jbeuckm/thrust_bucket/eagle/thrust_stand.brd

## EAGLE design eagle/thrust_stand.brd (2017-02-22)

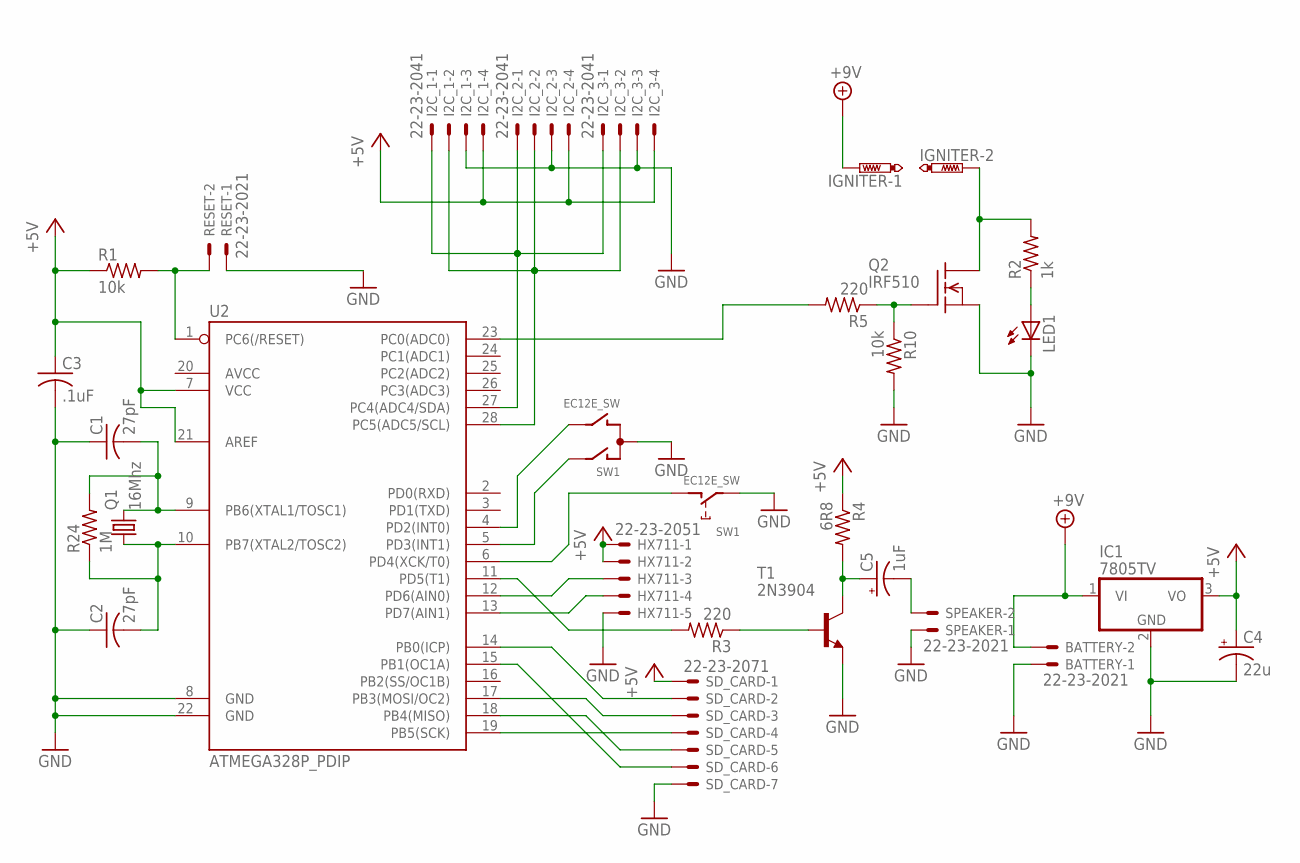
[picture p3: schematic thrust_stand.sch]

Parts:
BATTERY: 22-23-2021
C1, C2: 27pF; C025-040X050
C3: .1uF; C025-030X050
C4: 22u; B45181A
C5: 1uF; B45181A
HX711: 22-23-2051
I2C_1, I2C_2, I2C_3: 22-23-2041
IC1: 7805TV; TO220V
IGNITER: PTR2; P2-38-17
LED1: LED5MM
Q1: 16Mhz; HC49/S
Q2: IRF510; TO220
R1, R10: 10k; 0207/7
R2: 1k; 0207/7
R3: 220; 0207/7
R4: 6R8; 0207/7
R5: 220; 0309/10
R24: 1M; 0207/7
RESET: 22-23-2021
SD_CARD: 22-23-2071
SPEAKER: 22-23-2021
SW1: EC12E_SW; ALPS_EC12E_SW
T1: 2N3904; TO92
U2: ATMEGA328P_PDIP; DIL28-3

Connections:
+5V: C3.1, C4.+, HX711.1, HX711.2, I2C_1.4, I2C_2.4, I2C_3.4, IC1.3 (VO), R1.1, R4.1, SD_CARD.1, U2.7 (VCC), U2.21 (AREF)
+9V: BATTERY.2, IC1.1 (VI), IGNITER.TP-1
GND: BATTERY.1, C1.1, C2.1, C3.2, C4.-, HX711.5, I2C_1.3, I2C_2.3, I2C_3.3, IC1.2 (GND), LED1.K (C), Q2.3 (S), R10.2, RESET.1, SD_CARD.7, SPEAKER.1, SW1.C, SW1.E (2), T1.3 (E), U2.8 (GND), U2.22 (GND)
unnamed: I2C_1.2, I2C_2.2, I2C_3.2, U2.28 (PC5(ADC5/SCL))
unnamed: I2C_1.1, I2C_2.1, I2C_3.1, U2.27 (PC4(ADC4/SDA))
unnamed: HX711.3, U2.12 (PD6(AIN0))
unnamed: C1.2, Q1.2, R24.2, U2.9 (PB6(XTAL1/TOSC1))
unnamed: C2.2, Q1.1, R24.1, U2.10 (PB7(XTAL2/TOSC2))
unnamed: HX711.4, U2.13 (PD7(AIN1))
unnamed: SD_CARD.2, U2.14 (PB0(ICP))
unnamed: SD_CARD.3, U2.17 (PB3(MOSI/OC2))
unnamed: SD_CARD.4, U2.19 (PB5(SCK))
unnamed: SD_CARD.5, U2.18 (PB4(MISO))
unnamed: SD_CARD.6, U2.15 (PB1(OC1A))
unnamed: Q2.1 (G), R5.1, R10.1
unnamed: R3.2, U2.11 (PD5(T1))
unnamed: R3.1, T1.2 (B)
unnamed: C5.+, R4.2, T1.1 (C)
unnamed: C5.-, SPEAKER.2
unnamed: IGNITER.TP-2, Q2.2 (D), R2.2
unnamed: R5.2, U2.23 (PC0(ADC0))
unnamed: SW1.B, U2.4 (PD2(INT0))
unnamed: SW1.A, U2.5 (PD3(INT1))
unnamed: LED1.A, R2.1
unnamed: SW1.D (1), U2.6 (PD4(XCK/T0))
unnamed: R1.2, RESET.2, U2.1 (PC6(/RESET))

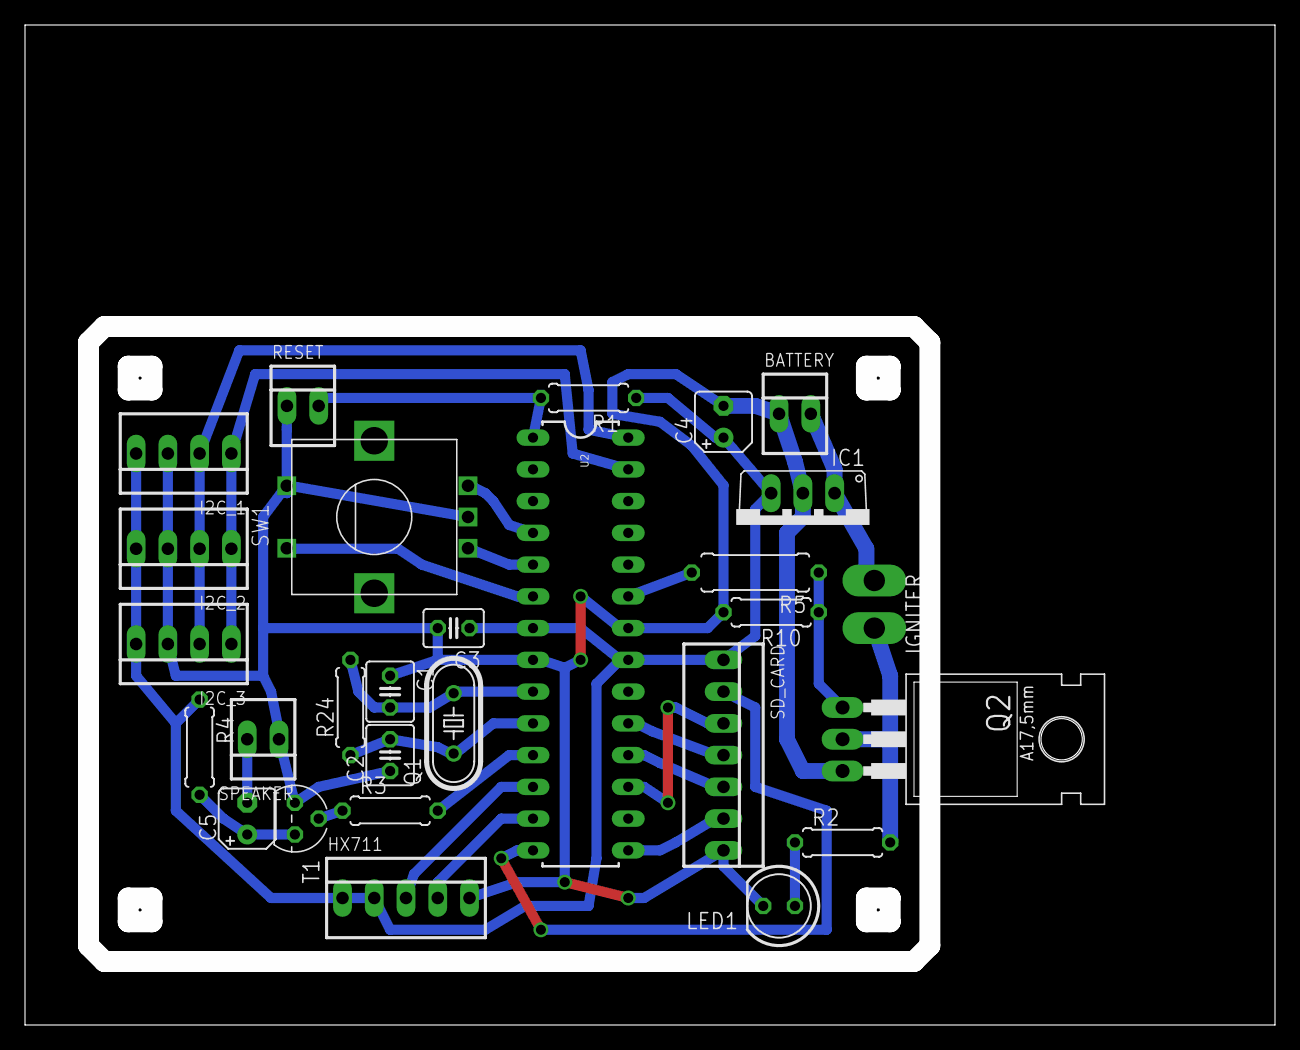
[picture p4: board thrust_stand.brd from above]

Board: 2 copper layers, 100.0 x 80.0 mm, 28 parts (0 on the bottom side), 26 nets.
