jbeuckm/thrust_bucket/sd_card/TESTS.CSV

THRUST0.TSV
THRUST23.TSV
