jbeuckm/thrust_bucket/(threads)

Thread 1 (2017-02-18):

Improve Calibration Process

jbeuckm, 2017-02-18:
When in calibration mode with Calibration function selected...

Button down: Turn knob to make ballpark changes to scale value
Button up: Turn knob to make fine adjustment
Button down/up again: release the knob for function select/mode change

jbeuckm, 2017-02-21:
handled in 4064e74a9a2209aa1cbc943495d86aceadedaa5f

Closed 2017-02-21.
