jbeuckm/thrust_bucket/thrust_bucket_atmega/IgniteMode.cpp

/*
 * IgniteMode.cpp
 *
 *  Created on: Feb 11, 2017
 *      Author: joebeuckman
 */

#include "IgniteMode.h"
#include "ChangeModeFunction.h"


IgniteMode::IgniteMode(HX711 *_scale, rgb_lcd *_lcd): BaseMode(_scale, _lcd) {
	scale = _scale;
	lcd = _lcd;
	functionIndex = 0;

	FUNCTION_COUNT = 1;

	modeFunctions = (BaseModeFunction **) malloc(FUNCTION_COUNT * sizeof(BaseModeFunction*));

	modeFunctions[0] = new ChangeModeFunction(F("[Cancel]"), -2);

	setupSDcard();

	Serial.println(F("IgniteMode() complete"));
}


void IgniteMode::setupSDcard() {
	pinMode(IGNITER_PIN, OUTPUT);

	pinMode(SS, OUTPUT);

	if (!SD.begin(chipSelect)) {
		Serial.println(F("SD init failed"));
	}

	thrustDataFilename = findNextFilename();

	//  SdFile::dateTimeCallback(dateTime);
	thrustDataFile = SD.open(thrustDataFilename, O_WRITE | O_CREAT | O_TRUNC);

	if (!thrustDataFile) {
		Serial.print(F("error opening "));
		Serial.println(thrustDataFilename);
	}

	thrustDataFile.println(F("millis\traw\tload"));
}


String IgniteMode::findNextFilename() {

	String prefix = F("THRUST");
	String suffix = F(".TSV");

	String filename;

	int cardinal = 0;
	do {
		filename = prefix + cardinal + suffix;
		cardinal++;
	} while (SD.exists(filename));

	return filename;
}


void IgniteMode::startMode() {

	lcd->clear();
	lcd->setRGB(255, 200, 0);
	lcd->print(F("FIRING!!!"));

	BaseMode::startMode();

	timestamp = millis();
	updateMode();
	digitalWrite(IGNITER_PIN, HIGH);
	timestamp = millis();
}


int IgniteMode::updateMode() {

  unsigned long next_millis = millis();
  int elapsed = next_millis - timestamp;

  double value = scale->get_value(1);

  thrustDataFile.print(elapsed);
  thrustDataFile.print("\t");
  thrustDataFile.print(value);
  thrustDataFile.print("\t");
  thrustDataFile.println(value / scale->get_scale());

  if ( elapsed >= 5000) {
    finish();
    return 1;
  }

  return 0;
}


void IgniteMode::finish() {

	digitalWrite(IGNITER_PIN, LOW);

	thrustDataFile.flush();
	thrustDataFile.close();

	lcd->clear();
	lcd->setRGB(0, 0, 200);

	lcd->setCursor(0, 0);
	lcd->print(thrustDataFilename);

	thrustDataFile = SD.open(thrustDataFilename);
	int size = thrustDataFile.size();
	thrustDataFile.close();

	lcd->setCursor(0, 1);
	lcd->print("wrote ");
	lcd->print(size);
	lcd->print(" bytes.");

	writeDirectoryCsv();

	delay(10000);
}


void IgniteMode::writeDirectoryCsv() {

	File dirFile = SD.open("TESTS.CSV", O_WRITE | O_CREAT | O_TRUNC);

	String prefix = F("THRUST");
	String suffix = F(".TSV");

	String filename;

	int cardinal = 0;
	while (true) {
		filename = prefix + cardinal + suffix;

		if (SD.exists(filename)) {
			dirFile.println(filename);
		} else {
			break;
		}

		cardinal++;
	}

	dirFile.close();
}
