jbeuckm/thrust_bucket/thrust_bucket_atmega/BaseMode.h

#include "rgb_lcd.h"
#include "HX711.h"
#include "BaseModeFunction.h"

#ifndef BASE_MODE
#define BASE_MODE

class BaseMode {

protected:
  void showFunctionName();

  BaseModeFunction **modeFunctions;
  int FUNCTION_COUNT = 0;
  int functionIndex = 0;

  HX711 *scale;
  rgb_lcd *lcd;
  

public:
  BaseMode(HX711 *_scale, rgb_lcd *_lcd);
  void zeroModeChangeRequests();
  virtual void startMode();
  virtual int updateMode() = 0;
  void handleWheelRotation(int wheelRotation);
  void handleButtonDown();
  void handleButtonUp();
};

#endif
