jbeuckm/thrust_bucket/thrust_bucket_atmega/BaseModeFunction.cpp

#include "BaseModeFunction.h"


BaseModeFunction::BaseModeFunction() {
}
BaseModeFunction::BaseModeFunction(HX711 *_scale, rgb_lcd *_lcd) {
  scale = _scale;
  lcd = _lcd;
  trapWheelRotation = false;
}

void BaseModeFunction::handleWheelRotation(int wheelRotation) {
}
void BaseModeFunction::handleButtonUp() {
}
void BaseModeFunction::handleButtonDown() {
}

int BaseModeFunction::getChangeModeRequest() {
	return changeModeRequest;
}
void BaseModeFunction::setChangeModeRequest(int _change) {
	changeModeRequest = _change;
}
