jbeuckm/thrust_bucket/thrust_bucket_atmega/ChangeModeFunction.cpp

/*
 * AdvanceModeFunction.cpp
 *
 *  Created on: Feb 11, 2017
 *      Author: joebeuckman
 */

#include "ChangeModeFunction.h"

ChangeModeFunction::ChangeModeFunction(String _label, int _direction)
	: label(_label), direction(_direction) {

}

String ChangeModeFunction::getLabel() {
	return label;
}

void ChangeModeFunction::handleButtonUp() {
	changeModeRequest = direction;
}
