jbeuckm/thrust_bucket/(commit log)

2017-01-18 added hx711 to schemo
    [thrust_stand.sch]
2017-01-18 added speaker to schemo
    [thrust_stand.sch]
2017-01-18 parts placed
    [thrust_stand.brd, thrust_stand.sch]
2017-01-19 larger header for igniter
    [thrust_stand.sch]
2017-01-26 fixed breaks for each case in loop switch
2017-02-05 rotary encoder schemo and codes
    [thrust_stand.brd, thrust_stand.sch]
2017-02-05 routed with cutout
    [thrust_stand.brd, thrust_stand.sch]
2017-02-05 gcode for pcb
2017-02-06 spacer for load cell
2017-02-08 starting to try rotary encoder
2017-02-08 encoder working and hx711 reading
2017-02-09 scrolling through function names for calibration
2017-02-09 renaming to thrust_bucket
2017-02-09 added a calibrate mode
2017-02-09 trying to load calibration factor from eeprom
2017-02-09 now using a mode pointer instead of switch
2017-02-10 printing function labels now but nan for reading
2017-02-10 two functions available but switched hx711 read to counting for the moment - unknown problem reading could be hardware
    [BaseMode.cpp, BaseModeFunction.cpp, BaseModeFunction.h, CalibrateModeFunction.cpp, CalibrationMode.cpp, TareModeFunction.cpp, thrust_bucket.ino]
2017-02-10 moved trace strings to flash mem
2017-02-12 corrected constructor traces and cleanup
    [.ino.cpp, BaseMode.cpp, CalibrationMode.cpp, CountdownMode.cpp, CountdownMode.h, IgniteMode.cpp, IgniteMode.h, thrust_bucket_atmega.ino]
2017-02-13 corrected startMode ordering so function label shows
    [BaseMode.cpp, BaseModeFunction.h, CalibrationMode.cpp, CountdownMode.cpp, IgniteMode.cpp]
2017-02-13 starting a graph for thrust measurements
    [THRUST.TSV]
2017-02-19 better calibration sequence and motor holder CAM
2017-02-19 motor holder pic
2017-02-22 igniter moved to supply side and saving calibration value when finished calib
    [thrust_stand.brd, thrust_stand.sch]
2017-02-23 select element with latest test file selected
    [THRUST.TSV]
2017-02-25 coloring motor class scales
    [TESTS.CSV, THRUST0.TSV, THRUST23.TSV]
2017-02-25 showing motor classes
2017-03-06 wider legs on base and bigger holes in cap
2017-03-07 thrust in Ns
2017-03-07 showing avg thrust
2017-03-29 copying data results with test names
    [M10.TSV, M11.TSV, M5.TSV, M9.TSV]
